LadislavNagyy/sklenik-iot/docs/schema_dom.png

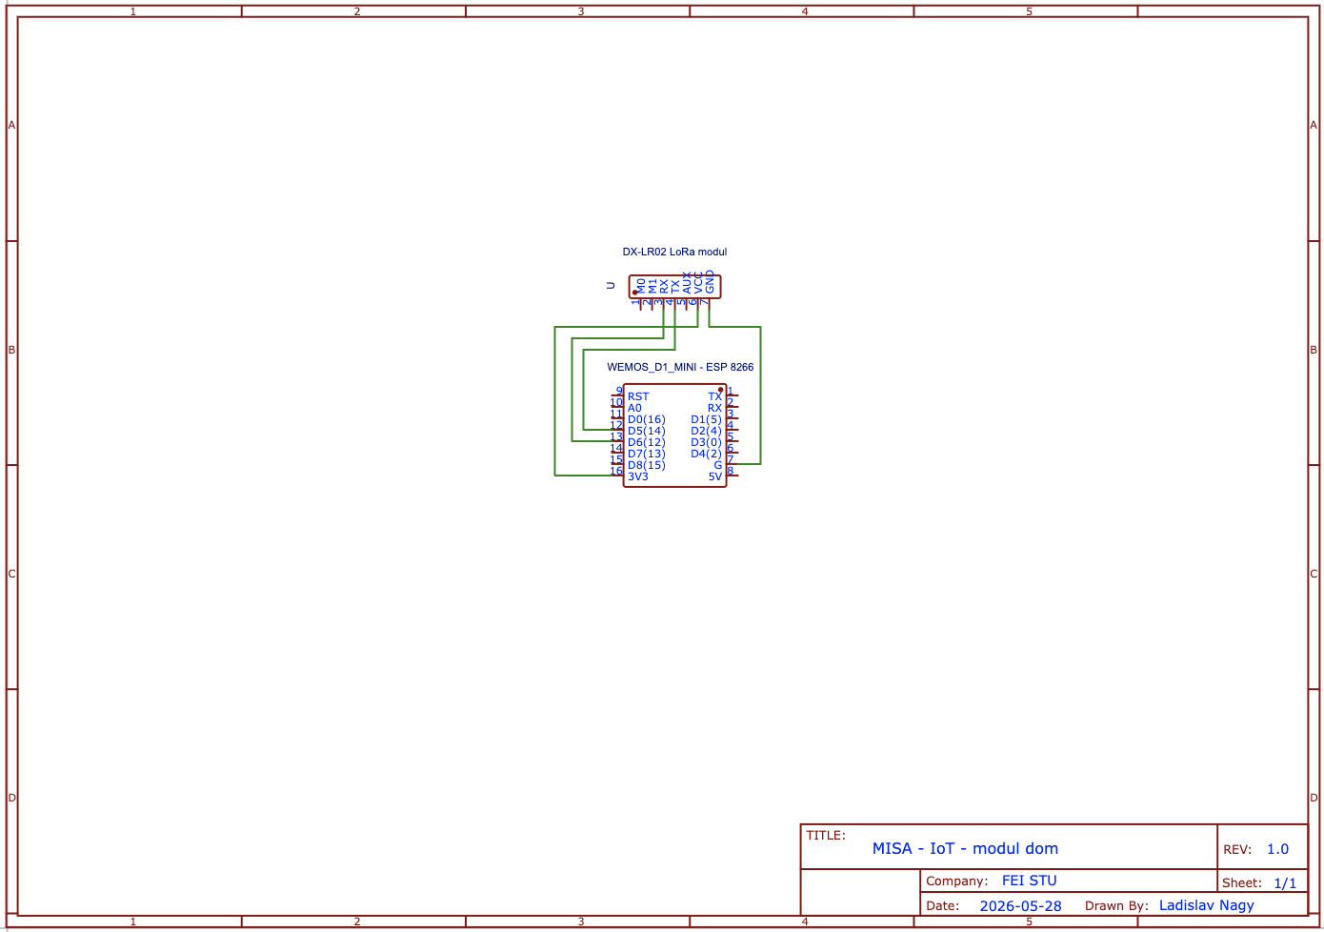
docs/schema_dom.png
