LadislavNagyy/sklenik-iot/docs/schema_sklenik.png

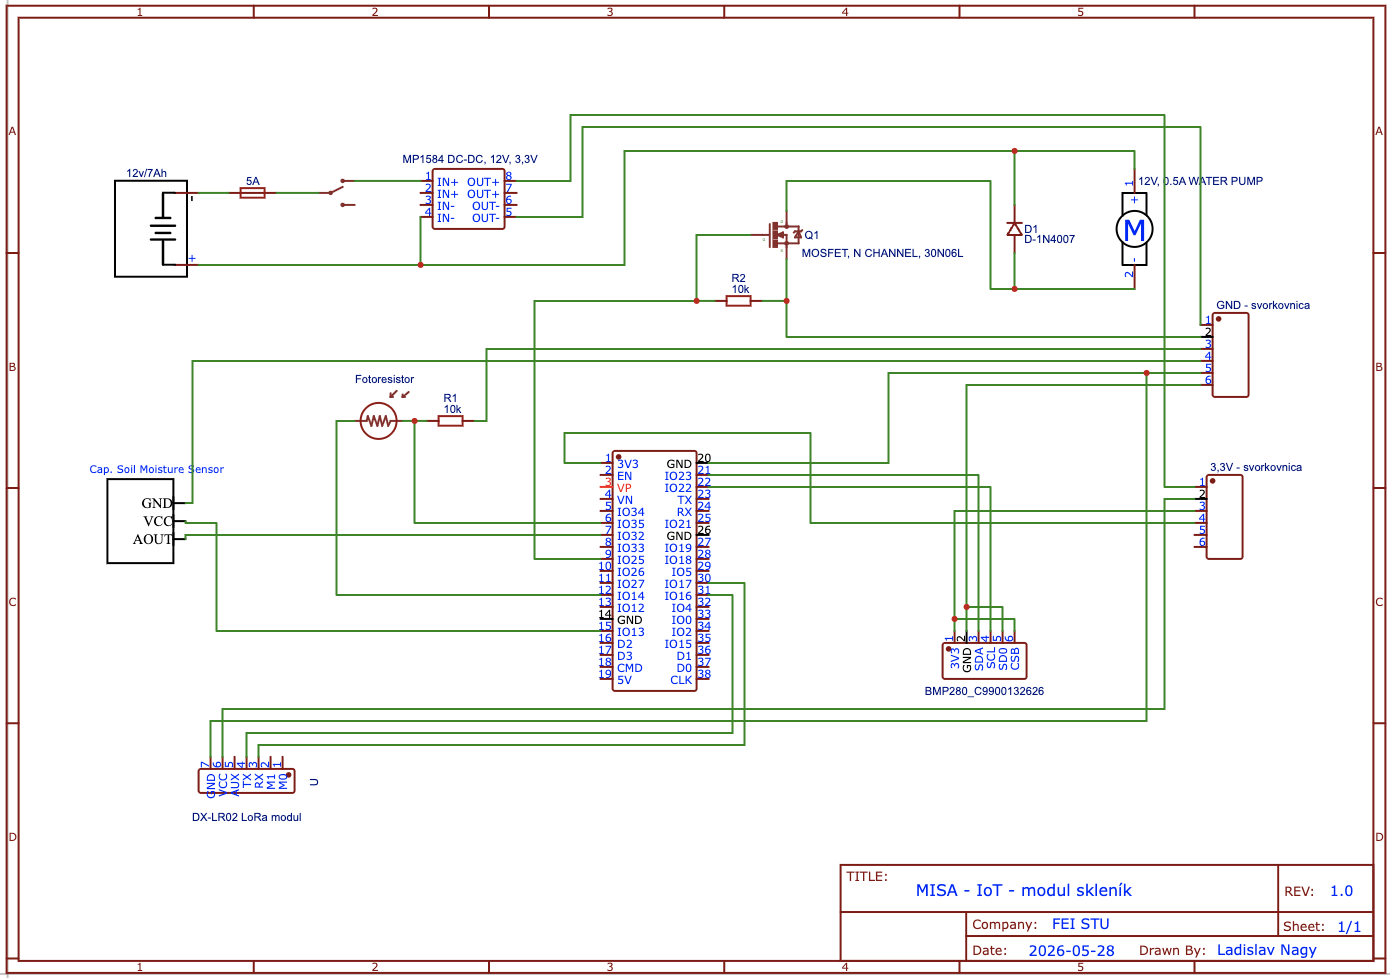
docs/schema_sklenik.png
