LadislavNagyy/sklenik-iot/(commit log)

2026-05-27 feat: ESP8266 MQTT gateway funkny + HA sensor konfig
2026-05-27 feat: ESP32 sklenik firmware - BMP280, senzory, LoRa odosielanie
2026-05-27 firmware: deep sleep, watchdog, pump control, log over MQTT
2026-05-27 firmware: pump startup protection, watchdog, deep sleep, MQTT log
2026-05-27 firmware: sensor calibration, night watering guard, programmer comments
2026-05-27 docs: mosquitto config, wiring diagrams, README, setup guide (HAOS); mask credentials
2026-05-28 fix: kalibracia senzorov, cerpadlo 10s
    [dom.ino, sklenik.ino]
